stayfoolishYang/2026Rc/README.md

# STM32 麦轮小车与机械臂控制工程

本仓库包含 STM32F103ZE 麦轮底盘/机械臂固件、Keil 工程、上位机串口接口，以及可视化硬件调参工作台。当前正式固件入口是 `USER/chassis_controller_main.c`。

当前源码基线为固件 `v181`。已恢复舵盘侧取物／放物的末段缓降，保留用户当前摄像头标定（mode84为36mm，mode85为18mm）；任务2从盘取杯仍按原逻辑使用普通速度。mode5/6毫米微调现在跟随87/88配置：mode87慢速400μs、mode88及上电默认快速200μs。任务2领奖台放置高度与摄像头打靶高度已拆开：mode33／34继续使用55／37mm，mode84／85分别升到当前标定36／18mm。升降有效上限为360mm，调参台共182项参数。mode 52 单独将 Servo1 收回到舵盘对位标定（当前2455 us）。保留底盘 mode 1/5 前后、mode 2/6 横移映射，独立元器件测试协议（mode 90–95）及 mode 71 单独闭合夹爪命令。上电时夹爪和底部转台 PWM 通道均保持为 0，不再自动松爪或回到 24°；其余初始化包括 Servo1 收回、陀螺仪、升降 GPIO、底盘、串口和 PE6 输入，不包含上电自动升降、自动抓放、自动移动或一次性参数候选分支。mode 80/81/82/83 是调参工作台长期使用的受限试动接口，mode 126 是保留的陀螺仪诊断接口，均不属于上电自动测试；mode 89 启用比赛启动后会锁定舵机试动和元器件运动测试。

## 仓库结构

- `USER/Template.uvprojx`：Keil MDK 工程。
- `USER/chassis_controller_main.c`：UART1 指令监听、麦轮运动、升降、舵机、任务动作和陀螺仪逻辑。
- `HARDWARE/`、`SYSTEM/`、`CORE/`、`STM32F10x_FWLib/`：硬件驱动、系统支持、启动文件和 STM32 标准库。
- `stm32_hardware_tuning_gui.py`：参数读取/写回、串口试动、编译、导出 BIN 和烧录工作台。
- `upper_host_v86/`：供树莓派或其他上位机调用的 Python 串口接口。

`OBJ/`、`USER/Listings/`、`__pycache__/`、BIN、Keil 中间文件和日志均为生成物，不提交到 Git。

## 硬件与工具

- STM32F103ZE High-density，512 KiB Flash。
- Keil MDK-ARM 5.x，ARMCC 5.06 工具链，STM32F1xx DFP。
- Windows Python 3.10 或更高版本。
- Windows Tkinter（通常随 Python 安装）。
- 串口转换器/下载线。默认上位机串口为 `COM14`，波特率 `115200`。

## 安装 Python 依赖

在仓库根目录执行：

```powershell
python -m pip install -r requirements.txt
```

如果电脑安装了多个 Python，请使用实际启动工作台的解释器：

```powershell
py -3 -m pip install -r requirements.txt
```

依赖包括 `pyserial`、`loguru` 和 `stm32loader`。

## 启动调参工作台

2026-10-16 13:08 已通过COM14烧录v181舵盘缓降恢复版：任务1／2放入舵盘、任务1从盘取物的末段缓降已恢复；任务2从盘取杯保持原有普通速度；赛场地面／堆叠和领奖台缓降继续保留。用户当前摄像头标定（mode84为36mm、mode85为18mm）原样保留。芯片UID `FF38-05D4-30435630-43198431` 在擦除前匹配；15744字节完整回读与BIN一致，`Verification OK`，复位后收到 `FF 02 FE`，串口已释放。BIN：`OBJ/chassis_hardware_tuning_v181_restore_disc_slow.bin`，SHA-256 `2759ED3536F8F680AA63C330062D641A7AE38F60C0BF1E4DC910A0E31D87CDEF`。证据：`diagnostics/20261016_restore_disc_slow/flash_result.json`。本次未发送运动测试指令；以下较早记录保留为历史。

2026-10-16 12:31 已通过COM14烧录v180舵盘普通速度版：舵盘侧取物／放物取消末段缓降，统一使用普通升降速度；任务1最终赛场地面／堆叠放置和任务2领奖台放置仍保留末段缓降。芯片UID `FF38-05D4-30435630-43198431` 在擦除前匹配；15744字节完整回读与BIN一致，`Verification OK`，复位后收到 `FF 02 FE`，串口已释放。BIN：`OBJ/chassis_hardware_tuning_v180_disc_normal_speed.bin`，SHA-256 `E02B9519C7C525594C50A837061307838141F6D87066DA42700AD136DA4B6AA9`。证据：`diagnostics/20261016_disc_no_slow/flash_result.json`。本次未发送运动测试指令；以下较早记录保留为历史。

2026-10-10 23:05 已通过COM14烧录v178毫米微调双配置版：mode87下mode5/6使用400μs，mode88及上电默认使用100μs。芯片UID `FF38-05D4-30435630-43198431` 在擦除前匹配；15744字节完整回读与BIN一致，`Verification OK`，复位后收到 `FF 02 FE`，串口已释放。BIN：`OBJ/chassis_hardware_tuning_v178_fine_profiles_100_400.bin`，SHA-256 `FC0FD98DC5104BAD4AF9FBB3B3C6EF70DD6429021F19F7ACAC2C5E1BCD132406`。证据：`diagnostics/fine_speed_profiles_20261010_230037/flash_result.json`。本次未发送运动测试指令；以下较早记录保留为历史。

2026-10-10 20:36 已经 COM14 重新烧录“取消速度校验前的速度及舵机延时恢复版”v177。BIN 为 `OBJ/chassis_v177_restored_speed_waits_20261010.bin`，15736字节，SHA-256 `A74DA58B3154A3C6FD6245A3C17AFD1D7930B1E654BA54EA92B5AF5EBE0EF677`，完整回读一致并收到 `FF 02 FE`；详情见 `diagnostics/20261010_restore_speed_waits/restoration_evidence.json`。以下其他日期的烧录记录保留为历史证据。

速度输入已取消原来的40–500、40–1000、50–1500及15–500 us等固定范围，也不再要求起停半周期大于巡航、末段半周期大于普通升降。十项步进半周期只保留当前 `delay_us` 计时器的正整数表示范围1–233015 us。起停值不大于巡航值时，现有固件会采用固定速度，不启用该段加减速。新版窗口标题包含“时间参数梳理版”；已运行的旧窗口需要重新打开程序才能使用新分组和对应说明，关闭前请先导出尚未保存的参数方案。

### 时间参数的查找与实际作用

2026-10-10按正式入口调用关系整理了时间参数，固件源码、标定数值和板上程序保持原样。v179后可编辑参数为182项：移出三项未使用的历史等待，补入三个实际使用的等待，并新增两项摄像头打靶高度；16个任务的126项专用等待全部保留。

| 要调整的内容 | 调参台位置 | 如何理解 |
| --- | --- | --- |
| 任务1／任务2直线速度 | 参数标定 → 各自直线速度组 | STEP半周期，单位μs，越小越快 |
| 旋转、毫米微调、起停曲线 | 参数标定 → 旋转与微调／加减速与距离判定 | 起停与巡航分开；每端曲线脉冲数0或1表示不启用曲线 |
| 升降速度和下降末段 | 参数标定 → 升降速度与末段 | 普通速度与下降末段分开；末段长度0表示无独立末段 |
| 某个完整抓取／放置任务的等待 | 任务等待时间 → 选中具体任务 | 专用字段按实际动作顺序排列；下方另列公共字段及使用次数 |
| 单独收回、张爪、转台等命令 | 任务等待时间 → 公共等待与独立命令 | 按实际mode说明等待来源，显示当前毫秒数 |
| 陀螺仪、通信、GUI超时 | 任务等待时间 → 系统通信与超时（只读） | 这些时间不控制机械速度，GUI超时也不表示任务停止 |
| 历史等待字段是否有效 | 任务等待时间 → 历史未使用参数（只读） | 只在源码中定义，没有执行引用，不能用来调当前任务 |

必须区分：舵机PWM脉宽（μs）决定位置；步进STEP半周期（μs）决定速度；动作等待（ms）决定何时执行下一步。等待0表示不等待，当前舵机等待输入范围0–5000ms；等待是固定延时，不是舵机位置反馈。

`SERVO_POWER_ON_SETTLE_MS`虽然名字含“POWER_ON”，当前正式上电并不执行它；它用于mode36前伸、mode52收回、mode70全张开和mode72初始化收尾，当前500ms。`SERVO1_SETTLE_MS`还被任务中的公共伸缩对位使用；`SERVO2_SETTLE_MS`还被任务1从舵盘放到赛场的最终全张开使用；`SERVO3_SETTLE_MS`用于单项转台和mode72开始回正，完整任务去盘／回正有各自等待。

抓取到舵盘的“升至安全高度后停留”发生在上升结束后；从盘取物的“夹紧后额外停留”发生在上升前。任务1从舵盘放到赛场的最终松爪等待是公共Servo2等待＋该任务额外等待A＋额外等待B，当前代码没有分段张爪。界面实时显示每个任务的舵机固定等待合计，另说明不包含升降、换向和通信时间。

三项历史字段 `SERVO3_HOME_BEFORE_CLAW_OPEN_MS`、`ARM_ACTION_HOLD_MS`、`GROUND_RELEASE_STAGE_INTERVAL_MS`已改为只读参考，不再写回。新增可编辑的实际字段是 `SERVO_POWER_ON_SETTLE_MS`、`CHASSIS_DIRECTION_SETTLE_MS`、`LIFT_DIRECTION_SETTLE_MS`；旧JSON方案缺少它们时保留当前读到的数值，旧历史字段会忽略并写入日志。

完整逐项清单：`diagnostics/20261010_time_parameter_audit/时间参数对应清单.txt`；机器可读记录及源码位置：`diagnostics/20261010_time_parameter_audit/timing_inventory.json`。

双击 `启动硬件调参台.bat`，或执行：

```powershell
python stm32_hardware_tuning_gui.py
```

工作台默认读取 `USER/chassis_controller_main.c`，支持：

- 读取和精确写回 182 个硬件参数；
- Servo1/2/3、升降单项试动；
- 任务1、任务2动作试跑；
- “任务试跑”页可滚动查看全部动作按钮；
- 任务1抓取/放置按舵盘1~5、任务2抓取/放置按奖杯1~3（冠/亚/季）各自独立调时序（调参台新增“任务时序（二级）”页，先选动作再调每步等待）；
- 舵盘放物和任务1从盘取物恢复末段缓降；任务1最终赛场地面／堆叠放置、任务2领奖台放置保留末段缓降，当前最后 `40 mm` 使用 `120 us` 半周期；
- mode 84（摄像头打靶高位配置）、85（摄像头打靶低位配置）、86（底部舵机回24°）；
- 编译并检查 `0 Error(s), 0 Warning(s)`；
- 导出 BIN；
- 只对配置的串口进行烧录，并且只有出现 `Verification OK` 才报告成功。

工作台不会自动发送机械动作。执行试动或任务前，必须在界面中确认运动范围、升降零点和转台安全状态。

## 伸缩默认收回与舵盘对位

v177 已删除2350 us独立避让参数、30 mm分界及其升降联动。上电、初始化、地面抓取前收回、舵盘对位和 mode 52 均使用 `SERVO1_DISC_ALIGN_PULSE_US = 2455 us`。调参台只保留“默认收回 / 舵盘对位位置”和任务2前伸两个伸缩参数，当前参数总数为182。

普通升降及慢降只驱动升降 STEP，不因高度改变 Servo1；任务1圆柱与正方体堆叠放置均保持2455对位。任务2领奖台前伸仍使用已有 `SERVO1_TASK2_EXTEND_PULSE_US = 946 us`，升降也不会将这个任务位置自动收回。旧参数方案中的2350避让字段会被忽略，不能通过导入恢复已删除的联动。

mode 52（上位机 `MoveControl.grub_return()`；调参台“任务试跑 → Servo1 收回”）指令为 `FF 34 00 00 00 00 00 00 00 FE`，只写 TIM5_CH2，等待原有500 ms后返回 `FF 01 FE`。反馈表示命令处理完成，不是舵机位置反馈。

## 夹爪四状态与任务对应（v170）

任务按动作阶段明确选择 Servo2 状态，任务1所有舵盘及任务2共用四个参数：

| 状态 | 宏 | 当前脉宽 | 使用阶段 |
| --- | --- | --- | --- |
| 夹紧 / 转运保持 | `SERVO2_CLAMP_PULSE_US` | 1460 us | 普通物块或奖杯夹住后，保持夹紧升降与转台；正方体有独立夹紧参数 |
| 舵盘高位抓取张开 | `SERVO2_DISC_PICK_OPEN_PULSE_US` | 1367 us | 升至对应任务的转盘安全高度、伸缩对位并转到目标舵盘后，张开再下降夹取 |
| 舵盘低位放块张开 | `SERVO2_DISC_RELEASE_PULSE_US` | 1366 us | 地面物块放入舵盘，降至对应任务的舵盘放置高度后松开 |
| 地面抓取 / 放置全张开 | `SERVO2_BOTTOM_OPEN_PULSE_US` | 765 us | 地面抓取前留出识别空间；地面/领奖台放置、任务结束及mode70 |

“舵盘低位”表示舵盘作业高度。夹爪不会仅因经过某个高度就切换状态。

| 任务 | 升降、伸缩、转台与夹爪顺序 |
| --- | --- |
| 任务1地面 → 舵盘，mode7/8/9/10/12 | 地面夹取后升到任务1转盘安全高度、伸缩对位并转到盘位；末段缓降至舵盘放置高度松开；升回安全高度、转台回正、张爪并回到待机高度 |
| 任务2地面 → 舵盘，mode42/43/44 | 地面夹杯后升到任务2转盘安全高度并转到盘1/3/5；末段缓降至独立任务2放杯高度松开；升回安全高度、回正、张爪并回到待机高度 |
| 任务1舵盘 → 赛场，mode14/15/16/17/18 | 升到安全高度、转到盘位并张爪；末段缓降至舵盘取物高度夹紧；升回安全高度并回正；最终赛场地面／圆柱顶部放置仍使用末段缓降 |
| 任务2舵盘 → 领奖台，mode33/34/35 | 升任务2转盘高度（当前250 mm）、伸缩2455、转至盘1/3/5、1367张开；降181 mm夹紧1460；升221 mm、伸缩946、转台回正；缓降领奖台55/37/25 mm，765全开；升170 mm保持前伸 |

mode16不再使用舵盘3专用1215，任务2取盘不再使用1173，地面放置不再经过1018中间角度。旧参数方案可继续导入，这三个旧字段不参与新任务；其余标定保持。地面全开后先等待 `SERVO2_SETTLE_MS`（当前380 ms），再等待原 `PUT*_STAGE_INTERVAL_MS`（当前100 ms，现表示额外保持）及 `PUT*_FINAL_OPEN_HOLD_MS`，随后回升。

调参台“Servo2 夹爪”只显示四个状态。在“任务时序（二级）”选中任务，可看到“本任务的元器件对应（当前输入值）”；修改相关参数时说明同步更新，不发送任何命令。输入值代表待保存标定，保存、编译并烧录后才改变板上完整任务；界面不提供实时机械位置反馈。

## 2/4号舵盘正方体的独立夹爪参数（v170）

任务1的 mode 8/10 是地面抓取正方体后放到舵盘2/4，mode 15/17 是从舵盘2/4抓取正方体后放回地面。它们在调参台中单独列为“Servo2 正方体（舵盘2/4）”，有三项参数：

| 参数 | 当前脉宽 | 使用阶段 |
| --- | ---: | --- |
| `SERVO2_CUBE_GROUND_CLAMP_PULSE_US` | 1470 us | 正方体从地面抓取时夹紧；地面抓取前的松开仍使用公共地面全开值 |
| `SERVO2_CUBE_DISC_OPEN_PULSE_US` | 1337 us | 正方体从舵盘2/4抓取前，在高位松开后下降 |
| `SERVO2_CUBE_DISC_CLAMP_PULSE_US` | 1470 us | 正方体在舵盘2/4高度夹紧 |

圆形物块的 mode 7/9/12、14/16/18 和任务2不使用这三个正方体参数；舵盘低位放块的公共松开值仍为 `SERVO2_DISC_RELEASE_PULSE_US`。旧的 v169 参数方案缺少这三项时，调参台导入会保留当前源码中的新值。

## 舵盘2/4的赛场堆叠放置高度（v171）

调参台“参数标定 → 升降高度”分别列出两项，供“圆柱在下、正方体在上”的末段放置调整：

| 调参项 | 宏 | 当前标定 | 对应阶段 |
| --- | --- | ---: | --- |
| 舵盘2正方体堆叠放置高度 | `LIFT_DISC2_STACK_PLACE_HEIGHT_MM` | 54 mm | mode15：从车载舵盘2取出后，转台回正、伸缩2455对位、下降到赛场圆柱顶部松开 |
| 舵盘4正方体堆叠放置高度 | `LIFT_DISC4_STACK_PLACE_HEIGHT_MM` | 54 mm | mode17：从车载舵盘4取出后，转台回正、伸缩2455对位、下降到赛场圆柱顶部松开 |

两项是相对于软件零点的绝对目标高度，范围0–360mm，步进1mm；不是在原高度上额外增加的距离。v171新增时沿用地面11mm初值，用户已调为54/54mm，本轮保留这些值。用户提供的 `D:/下载/决赛.pdf` 第8页规定圆柱高40mm，第12页允许同色物块叠放（红色A区、蓝色C区），51mm（11+40）曾作为首次试调参考，实际值按机构落点标定。v177取消了堆叠末段的2350前伸，圆柱和正方体放置均使用2455对位。堆叠需要先放好下层圆柱并对准同一目标位置。

本次高度只作用于mode15/17最后在赛场松开的阶段；mode8/10在车载舵盘存放，以及mode15/17在车载舵盘夹取，仍使用 `LIFT_PLACE_HEIGHT_MM`（当前163 mm）。mode14/16/18继续使用公共地面放置11 mm。任务时序页显示各盘独立的末段高度；旧176参数方案缺少这两项时，导入会保留当前输入的独立高度。修改输入后需保存源码、重新编译和烧录才会改变板上完整任务。

## 任务2放杯与取杯的独立高度（v172）

在“参数标定 → 任务2升降高度”集中显示如下四种角色；领奖台高度也在该组：

| GUI参数 | 源宏 | 当前值 | 生效阶段 |
| --- | --- | ---: | --- |
| 任务2奖杯放入舵盘高度 | `LIFT_TASK2_DISC_PLACE_HEIGHT_MM` | 163 mm | mode42/43/44，把地面奖杯放到盘1/3/5时，下降后松开的高度 |
| 任务2转台旋转安全高度 | `LIFT_TASK2_TRANSFER_HEIGHT_MM` | 250 mm | mode42/43/44携杯转到盘位及放杯后回正；mode33/34/35去盘取杯前旋转 |
| 任务2从舵盘取杯高度 | `LIFT_TASK2_DISC_HEIGHT_MM` | 181 mm | mode33/34/35，在车载舵盘夹紧已存奖杯的高度 |
| 任务2取杯后前伸/回正高度 | `LIFT_TASK2_RETURN_CLEARANCE_MM` | 221 mm | mode33/34/35夹紧后抬升，再前伸946并转台回正 |

此前mode42/43/44复用了任务1放盘163与转盘250，GUI标为任务1高度；调181只影响从盘取杯。v172为任务2独立接入两个新宏，初值复制原163/250，没有猜测实际避碰余量。转向舵盘5途中碰到已存杯，重点调转台旋转安全高度；对准盘位下降时发生干涉，则核对放入舵盘高度和机械间距。两个新参数供三块奖杯盘共用；任务1仍用原来的163/250。

GUI和固件均检查：任务2转盘高度必须高于放杯和取杯高度，取杯后回正高度必须高于取杯高度，且不得低于领奖台放置目标；各高度范围0–360mm。配置不满足时不执行任务2运动。数值顺序校验不代表实际已避开杯体/夹爪，仍需实测标定。旧178参数方案导入时，原冠军／亚军55／37mm会迁移为新的领奖台放置参数；摄像头高度保留当前源码值。

## 摄像头打靶高度与领奖台放置高度（v179）

mode84和mode85不再代表冠军／亚军领奖台。它们只驱动升降：mode84到摄像头打靶高位（当前 `36mm`），mode85到摄像头打靶低位（当前 `18mm`）。调参台在“摄像头打靶高度”组单独列出两项。

任务2把奖杯放到领奖台的高度仍在“任务2升降高度”组：mode33冠军为 `55mm`，mode34亚军为 `37mm`，mode35季军为 `25mm`。这三项只在完整奖杯放置任务最后的缓降松爪阶段使用，完全不受mode84／85影响。

## 元器件测试

打开“元器件测试”页，连接串口，点击“检测测试固件”。返回 `FF 07 FE` 后才允许使用新测试指令；旧固件会返回 `FF 00 FE`，此时应先烧录 v156。连接和固件检测不会发送运动指令。

页面支持四个车轮独立正反转、升降目标高度测试、三路舵机独立脉宽和 PE6 按键电平读取。每项动作需勾选上方运动范围确认并点击测试按钮；升降还需确认软件零点，转台还需确认旋转空间。可先把车轮架空，用默认 `200` 脉冲、`1000 μs` 半周期观察所选车轮。脉冲数上限 `3200`，元器件测试半周期范围为 `1–65535 μs`；升降目标范围为 `0–360mm`，不再限制单次最多移动 `10mm`。测试按数量自动结束。速度是名义值，串口轮询会增加少量时间。

“任务试跑 → 独立动作与初始化”有“夹爪单独闭合”按钮（mode71），使用当前 `SERVO2_CLAMP_PULSE_US` 夹紧值，只驱动夹爪。

同一页新增“底盘试跑”：直线距离默认 `5 cm`，允许 `±1–20 cm`，以及旋转角度默认 `10°`，允许 `±1–90°`。直线试跑使用 mode 1 前后移动命令，旋转试跑使用 mode 3 有符号角度旋转，不依赖元器件测试能力探测；两项都是阻塞式底盘命令，停止元器件测试按钮不能中断，必须先选择小范围并确认底盘周围无障碍。

| 元器件 | STEP / PWM | DIR | 单独控制 |
| --- | --- | --- | --- |
| 左前轮 MOTOR7 | PC8 | PA8 | mode 90，编号 7 |
| 右前轮 MOTOR4 | PC7 | PG8 | mode 90，编号 4 |
| 左后轮 MOTOR8 | PC9 | PC1 | mode 90，编号 8 |
| 右后轮 MOTOR3 | PC6 | PG7 | mode 90，编号 3 |
| 升降电机 | PB10 | PA4 | mode92，目标高度0–360mm |
| Servo1 伸缩 | PA1 / TIM5_CH2 | — | mode 94，编号 1 |
| Servo2 夹爪 | PA2 / TIM5_CH3 | — | mode 94，编号 2 |
| Servo3 转台 | PA3 / TIM5_CH4 | — | mode 94，编号 3 |
| PE6 按键 | PE6 输入 | — | mode 95，读取低/高电平 |

升降目标范围为 `0–360mm`，可以直接测试较大高度差。高度是发出的步数推算值，不含位置传感器反馈；上电前仍需人工放到底部。中途停止时固件保留不足1mm的步数，先在本页完成一次整数目标高度测试，才能恢复常规升降和抓放任务。

舵机脉宽范围 `500–2500 μs`，“使用当前标定值”只填入值，点击“发送脉宽”才运动。返回完成状态表示 PWM 已设置，不表示机械已到位。舵机持续输出该脉宽，直到新指令或停止；测试页不会改写源码标定值。Servo4 与 WS2812 共用 PA11，本页不启用此通道。

“停止元器件测试 / 关闭舵机信号”发送 mode 91，可在本页步进测试等待期间发送，返回 `FF 04 FE`。它将所有 STEP 置低并关闭三路舵机 PWM；驱动器共享 EN 保持原状态，升降电机仍保持使能。此按钮只中断元器件测试，不能中断原有阻塞任务。关闭或断开界面时，若测试仍在进行，会尝试发送停止；通信物理中断时无法保证收到停止，但步进测试仍按有限脉冲数结束。

PE6 读取返回 `FF 05 FE`（低/松开）或 `FF 06 FE`（高/按下），不会启用比赛启动。比赛启动 mode 89 之后，固件拒绝元器件运动测试，需复位后重新检测。测试页与“通信与构建日志”同时显示 TX/RX。**ACK 说明命令被处理，器件好坏仍需观察实物、电压和波形；系统不自动判定电路板或元器件合格。**

手动串口工具可使用 `FF + 8 字节 payload + FE`，多字节参数均为高字节在前：

| mode | payload（8 字节，未用位填 0） | 返回 |
| --- | --- | --- |
| 90 | `[90, 电机编号, DIR(0/1), 脉冲高, 脉冲低, 半周期高, 半周期低, 0]` | `FF 01 FE` 或停止 `FF 04 FE` |
| 91 | `[91, 0, 0, 0, 0, 0, 0, 0]` | `FF 04 FE` |
| 92 | `[92, 目标mm高, 目标mm低, 半周期高, 半周期低, 0, 0, 0]` | `FF 01 FE` 或停止 `FF 04 FE` |
| 93 | `[93, 0, 0, 0, 0, 0, 0, 0]` | `FF 07 FE` |
| 94 | `[94, 舵机编号, 脉宽高, 脉宽低, 0, 0, 0, 0]` | `FF 01 FE`（PWM 已设置） |
| 95 | `[95, 0, 0, 0, 0, 0, 0, 0]` | `FF 05 FE` / `FF 06 FE` |
| 70 | `[70, 0, 0, 0, 0, 0, 0, 0]` | `FF 01 FE`，地面全张开 |
| 71 | `[71, 0, 0, 0, 0, 0, 0, 0]` | `FF 01 FE`，按 `SERVO2_CLAMP_PULSE_US` 闭合 |

mode70/71是独立夹爪动作：70地面全张开；71按通用夹紧值闭合。调参台“任务试跑 → 独立动作与初始化”提供mode71按钮；上位机接口为 `MoveControl.grub_close()`。

例如左前轮 DIR 0、200 脉冲、1000 μs 半周期：`FF 5A 03 00 00 C8 03 E8 00 FE`；停止：`FF 5B 00 00 00 00 00 00 00 FE`。非法参数或锁定时返回 `FF 00 FE`。

离线检查可运行 `python -m unittest discover -s tests -v`：验证帧编码、参数边界、串口停止优先级、界面初始化和真实固件测试函数的模拟引脚行为。固件模拟测试需要 PATH 中存在 gcc；其他测试不连接真实串口。

## 跨电脑配置

工作台不依赖某个用户的固定目录。Keil 工具按以下顺序寻找：

1. `KEIL_UV4`：直接指定 `UV4.exe`；
2. `KEIL_FROMELF`：直接指定 `fromelf.exe`；
3. `KEIL_ROOT`：指定 Keil 安装根目录；
4. 常见安装目录和系统 `PATH`。

换电脑或换 USB 端口时，可以设置：

```powershell
$env:KEIL_ROOT = 'C:\Keil_v5'
$env:STM32_SERIAL_PORT = 'COM7'
$env:STM32_SERIAL_BAUD = '115200'
python stm32_hardware_tuning_gui.py
```

默认仍使用 `COM14` 和 `115200`，当前设备无需额外配置。

## 编译固件

在 Keil 中打开 `USER/Template.uvprojx`，确认安装 `STM32F1xx_DFP` 后执行 Build。工作台的“仅编译并检查日志”按钮也会执行同一工程构建，并在需要时自动创建 `OBJ/` 和 `USER/Listings/`。

当前源码及本轮确认板上版本为 `v177`，移除2350避让及30 mm升降联动。Keil 编译0错误0警告，2026-10-06 14:37经COM14写入，完整回读 `Verification OK`，复位后收到 `FF 02 FE`，串口已释放。产物 `OBJ/chassis_v177_default_retract_2455_20261006.bin` 为15740字节，SHA-256 `FE394AE015A7C16361E73368163EA8DA03F53DC03B71B0321D3006BC6534D3CA`；模拟验证和179项参数自检通过。本次没有发送完整任务或单项运动测试命令。详情见 `diagnostics/20261006_remove_servo1_clearance/result.md`。历史v175底盘映射及烧录记录保留在 `diagnostics/20261005_swap_translation_axes/progress.md`。

工程目标：

- Device：`STM32F103ZE`；
- Flash 起始地址：`0x08000000`；
- Flash 容量：`512 KiB`；
- 上位机 UART1：`115200 8N1`。

## 上位机接口

```python
from upper_host_v86 import MoveControl

control = MoveControl('COM14', 115200)
control.capToChampion()
control.capToRunnerUp()
control.turntable_home()
```

`MoveControl` 使用 `FF + 8 字节 payload + FE` 帧格式，并等待 STM32 返回 `FF 01 FE` 完成状态。换端口时，把构造函数的串口名改成目标端口。

场地坐标以 Home 区靠场内边线的中点为原点，车头朝场内时 `x` 向前、`y` 向图右。场地为横向 3660 mm、纵向 2440 mm。软件中的估算标记坐标、边界、相对移动量计算及现场校准说明见 [场地坐标草案](diagnostics/20261005_map_coordinates/coordinates.md)；数据在 `upper_host_v86/field_map.py`。示意图中的目标中心不是已校准停车位。

## 重要模式

```text
1/2                 X 前后 / Y 横移，厘米级移动
3                   旋转
5/6                 X 前后 / Y 横移，毫米微调
7/8/9/10/12         地面抓取到舵盘
14/15/16/17/18      舵盘放回地面
33/34/35             任务2舵盘1/3/5到冠亚季军台
42/43/44             任务2地面奖杯到舵盘1/3/5
52                   Servo1 单独收回到舵盘对位（当前2455 us）
80/81/82             Servo1/2/3 脉冲调参试动
83                   升降高度调参试动
84                   摄像头打靶高位（当前36mm）
85                   摄像头打靶低位（当前18mm）
86                   底部旋转舵机回 24°
87                   启用任务2独立底盘速度和对称加减速
88                   恢复任务1底盘速度和运动方式
89                   初始化完成后启用 PE6 启动按键
70                   夹爪全张开
71                   夹爪按通用夹紧参数单独闭合
90                   指定单个车轮、方向、脉冲数和半周期
91                   停止元器件测试并关闭三路舵机 PWM
92                   升降目标高度测试（目标0–360mm）
93                   检测元器件测试协议支持
94                   指定单个舵机的 PWM 脉宽
95                   读取 PE6 电平，不启用比赛启动
```

mode87/88切换当前上电周期内的直线移动配置：mode87启用任务2慢速，mode88恢复任务1快速，上电默认任务1。v178开始，mode5/6也跟随配置；当前源码任务1使用 `CHASSIS_FINE_STEP_HALF_PERIOD_US=200us`，任务2使用 `CHASSIS_TASK2_FINE_STEP_HALF_PERIOD_US=400us`。毫米微调优先于长距阈值判断，固定半周期，不使用起停曲线；调整长距阈值不会覆盖这两项速度。mode3旋转与mode20纠偏继续共用旋转参数，不跟随87/88切换。

当前源码任务2厘米移动为长距巡航 `100us`、短距巡航 `200us`；任务1为长距 `60us`、短距 `100us`、长距起停 `200us`，长距阈值500mm。旋转/纠偏为巡航 `100us`、起停 `350us`、每端700脉冲。这些现有用户标定保持不变。本轮新增的两档毫米微调在“参数标定→旋转与微调”中分别显示，单位为半周期μs，越大越慢；旧179项JSON缺少任务2微调时，导入保留当前读取的400μs。

旋转标定 `CHASSIS_ROTATE_180_PULSES` 已加入调参台“旋转与微调”组，当前暂时恢复历史值 `7790`。同启动诊断得到：7790 标定的 20°命令（866 脉冲）测得 `-36.66°`，4250 标定的 20°命令（472 脉冲）只测得 `-7.18°`；若系统线性，后者应约为 20°。该明显非线性与实物漂移一起证明，当前问题主要在驱动器细分/单轮跟随、失步、麦轮安装或地面滑移，不能继续通过一个全局脉冲常数补偿。硬件响应修复前不得重新标定。

任务1和任务2“从地面抓取并放到舵盘”的收尾回正等待，分别使用各任务的 `*_HOME_WAIT_MS`。不是历史全局500ms字段；当前每个任务可能有不同数值，请在“任务等待时间”中查看具体任务。

mode14–18（含mode16舵盘3搬运到地面）普通物块使用“舵盘高位抓取张开”1367 us；mode15/17的2/4号正方体改用独立舵盘松开/夹紧参数。所有舵盘抓取后的正式夹紧统一使用对应任务参数。

抓取/放置任务的126项专用等待按16个动作独立标定。任务1抓取（mode7/8/9/10/12）、放置（mode14–18）、任务2抓取（mode42/43/44）及领奖台放置（mode33/34/35）均有自己的等待字段。调参台“任务等待时间”先选动作，按真实阶段调整；同时显示公共伸缩等待，以及任务1最终松爪的公共夹爪等待。输入改动需保存源码、编译并烧录后才影响板上完整任务。三项历史全局等待只作只读参考，不参与当前正式入口。

任务2的三个物块舵盘位置为舵盘1、3、5：mode34/43使用舵盘3。任务2放杯到舵盘时，与任务1共用 `SERVO2_DISC_RELEASE_PULSE_US` 松开位置。v181恢复任务1／2放入舵盘、任务1从盘取物的末段缓降。任务2从盘取杯保持原有普通速度；赛场地面／堆叠和领奖台的末段缓降继续保留。

任务2把奖杯放到领奖台后，夹爪使用765 us全张开并等待后升降回升；任务2在舵盘侧抓取奖杯前与普通物块共用1367 us高位抓取张开状态。

## 当前正式机械参数

```text
Servo1 默认收回及舵盘对位 / 任务2伸出：2455 / 946 us
Servo2 夹紧 / 舵盘高位抓取张开 / 舵盘低位放块张开 / 地面全张开：1460 / 1367 / 1366 / 765 us
Servo2 正方体（2/4）地面夹紧 / 舵盘抓取松开 / 舵盘抓取夹紧：1470 / 1337 / 1470 us
Servo3 HOME / 舵盘1 / 舵盘2 / 舵盘3 / 舵盘4 / 舵盘5：678 / 1575 / 1790 / 2004 / 2223 / 2447 us

地面抓取 / 普通物块地面放置 / 任务1舵盘作业 / 任务2舵盘抓取 / 转台安全高度：16 / 11 / 163 / 181 / 250 mm
舵盘2 / 舵盘4正方体赛场堆叠放置高度：54 / 54 mm（独立参数，保留当前用户标定）
任务2放入舵盘 / 转盘安全 / 从盘取杯 / 取杯后回正高度：163 / 250 / 181 / 221 mm
任务结束待机高度：170 mm
冠军 / 亚军 / 季军台软件目标：55 / 37 / 25 mm（机械坐标标定，规则台面高36 / 18 / 0 mm）
普通升降 / 末段缓降：15 / 120 us 半周期；末段距离 40 mm

Servo1 / Servo2 / Servo3 公共固定等待：200 / 380 / 850 ms（用途见时间参数章节）
独立前伸 / 收回 / 全开命令等待：500 ms
底盘 / 普通升降 DIR到STEP等待：20 / 20 ms
完整任务去盘 / 回正 / 夹紧 / 松开 / 额外保持：各任务专用值，见任务等待时间页
```

## 上电启动流程

PE6 使用下拉输入，按下为高电平。上电后按键默认不触发任务；只有上位机完成机械初始化和陀螺仪归零并发送 mode 89 后，下一次有效按压才会上报 `FF 03 FE`。

```python
from upper_host_v86 import MoveControl

control = MoveControl("COM14", 115200)
control.initialize_and_wait_for_start()

# 收到 PE6 启动事件后，才从 Home 区域出发。
control.set_distance(x=0.6)
```

完整顺序为：等待 STM32 就绪 `FF 02 FE` → 机械初始化 mode 72 → 陀螺仪归零 mode 19 → 启用 PE6 mode 89 → 等待 `FF 03 FE` → 执行任务。mode 72 现在会在机械初始化真正完成后才返回 `FF 01 FE`，因此后续校准不会与初始化动作重叠。

## 引脚摘要

```text
上位机 UART1：PA9 TX、PA10 RX
陀螺仪 UART4：PC10 TX、PC11 RX
Servo1：TIM5_CH2 / PA1
Servo2：TIM5_CH3 / PA2
Servo3：TIM5_CH4 / PA3
升降 MOTOR1：PA4 DIR、PB10 STEP、PC5 EN
麦轮 STEP：PC6、PC7、PC8、PC9
```

Servo1/2/3 共用 TIM5，固件会先完成三通道配置并写入安全脉宽，再启动定时器，避免初始化阶段输出 0 us 无效脉冲。`HARDWARE/SERVO/servo.c` 保持 GBK/CP936 编码。Servo4 与 WS2812 都使用 TIM1_CH4 / PA11，存在资源冲突；当前正式入口不调用 `Servo4_Init()`。

## 安全说明

- 首次上电或复位后，固件中的软件升降高度从 `0 mm` 开始；执行升降/任务前应先把机构放到底部，并在工作台确认同步。
- 烧录前必须断开工作台串口，确认机械范围安全。
- 只有日志出现 `Verification OK` 才能判定烧录成功。
- 不要提交 `OBJ/`、BIN、Keil 中间文件、日志、Python 缓存或包含本机路径的调试配置。
