stayfoolishYang/2026Rc/hardware_revision/R2_geometry_preview.png

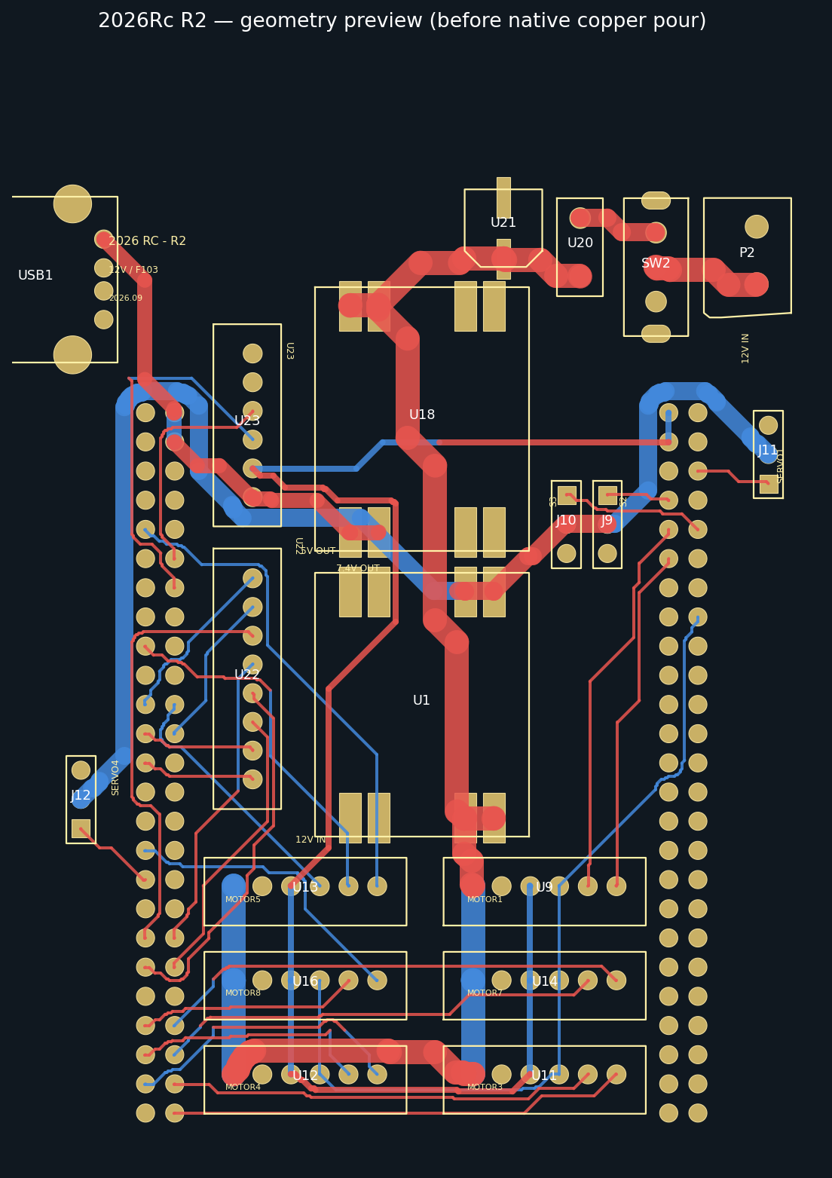
hardware_revision/R2_geometry_preview.png
