stayfoolishYang/2026Rc/(list of files, drawings)

Other design files:
hardware_revision/2026Rc_R1_DRC_checked.epro
hardware_revision/2026Rc_R1_power.epro
hardware_revision/2026Rc_R1b_power.epro
hardware_revision/2026Rc_R2_layout.epro
hardware_revision/2026Rc_R2_routed.epro
